Romukeisari/SRM-controller/Hardware/Leaf park actuator pinout.pdf

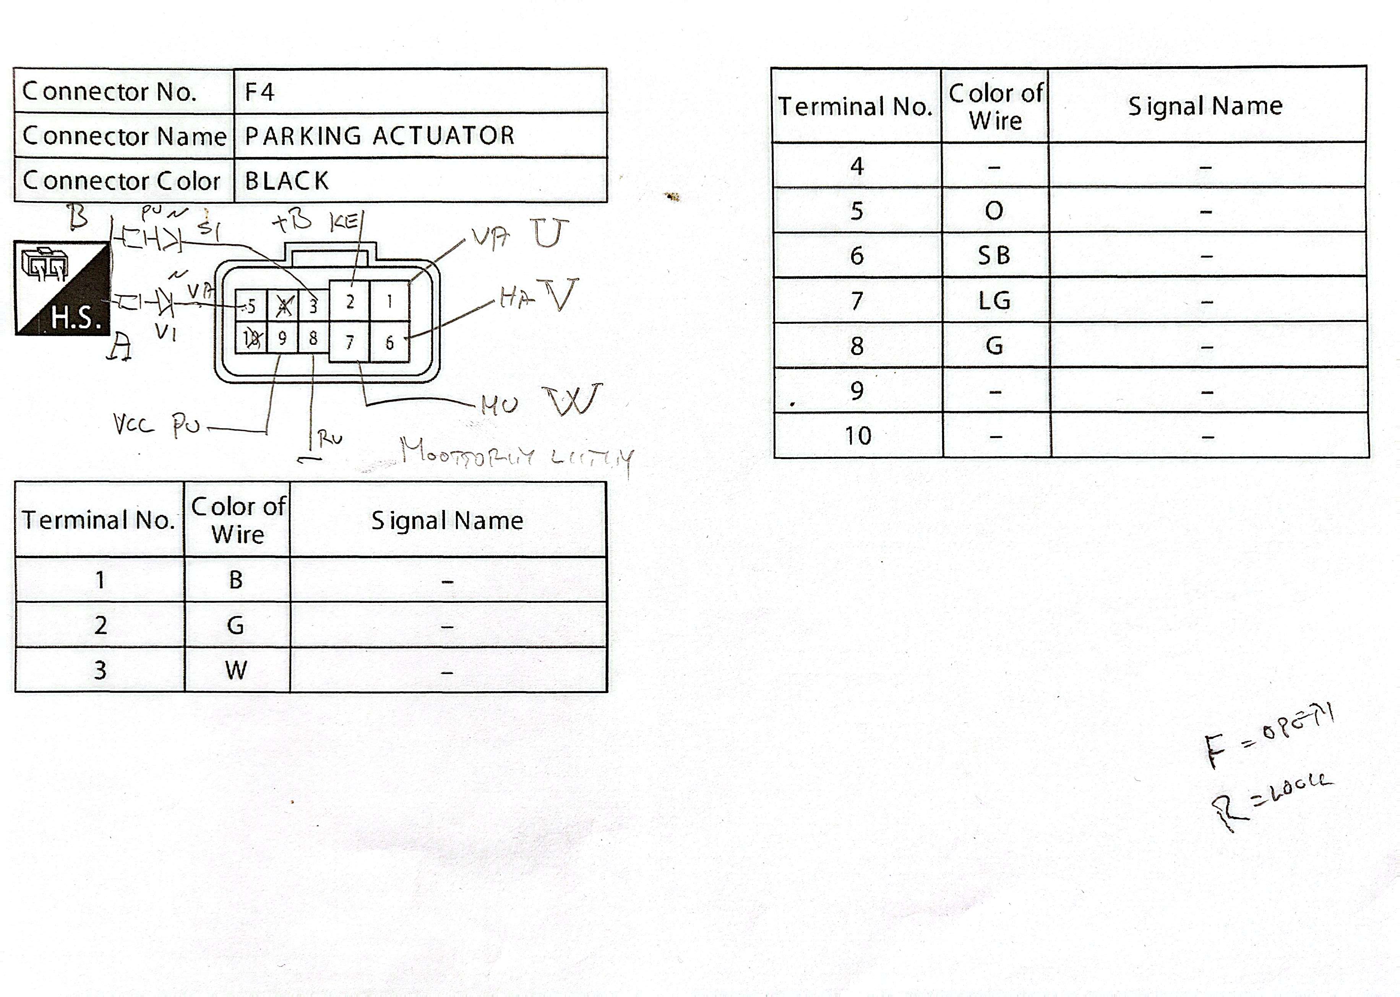
[picture p2: page 1]
