Romukeisari/SRM-controller/Hardware/SRM_motor_controller_A3_sch.pdf

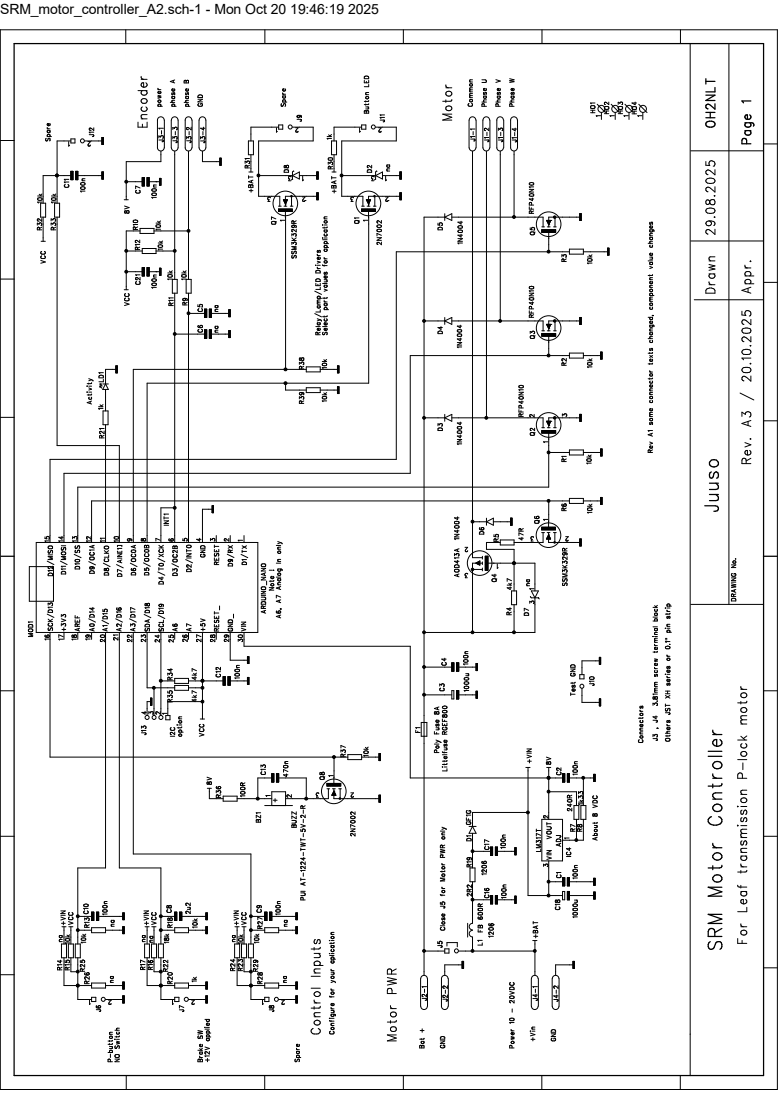
[picture p3: page 1]

SRM_motor_controller_A2.sch-1 - Mon Oct 20 19:46:19 2025
