Romukeisari/SRM-controller/Hardware/SRM_motor_controller_pcb.pdf

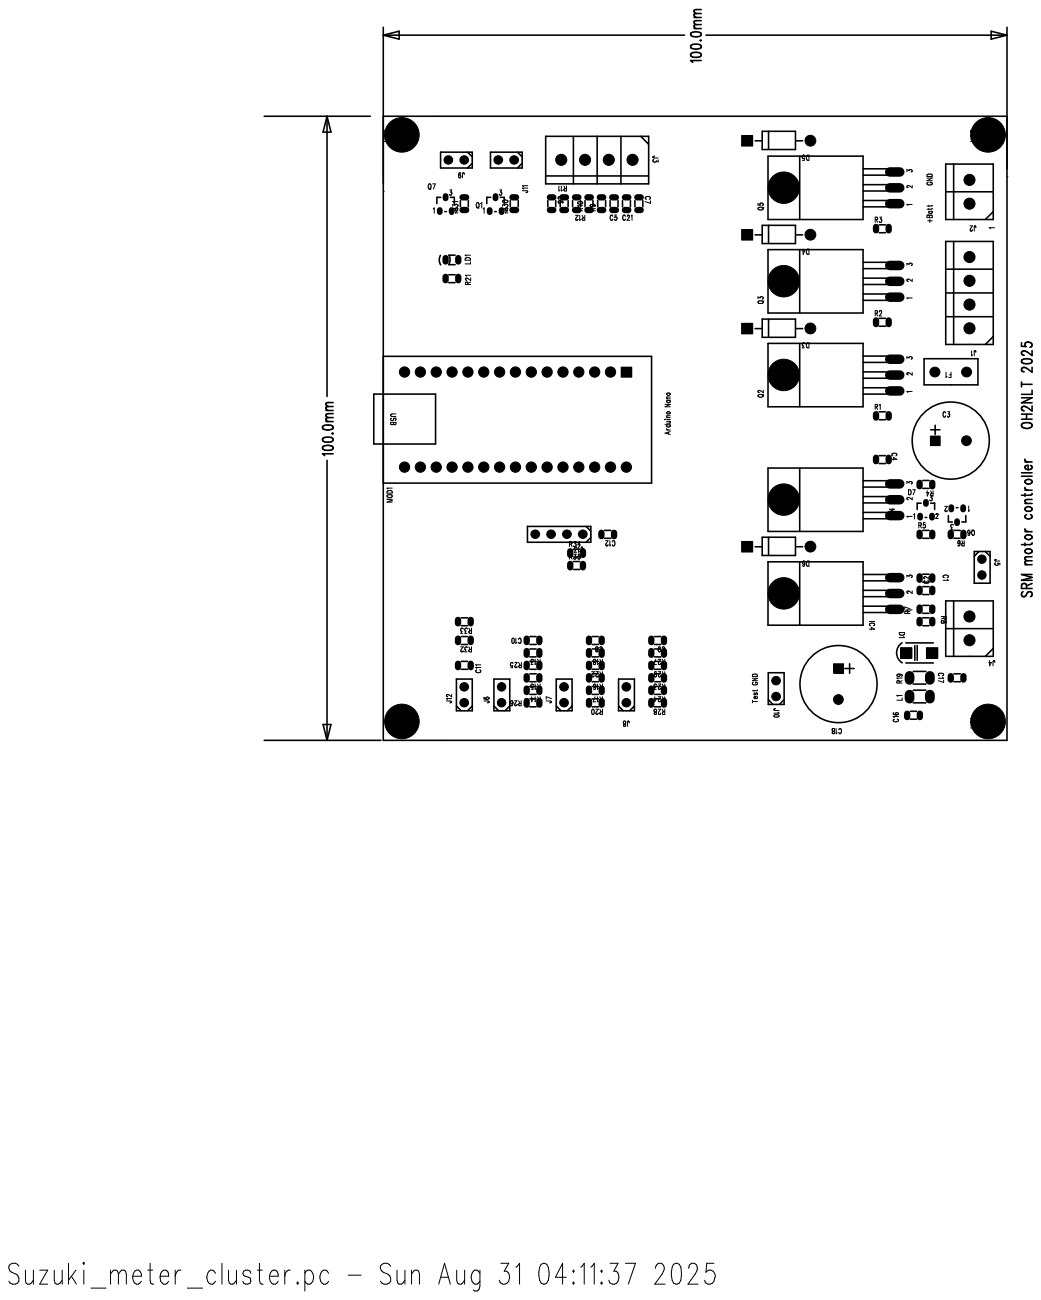
[picture p4: page 1]
